MayurPatil2711/ES-408-Mechatronics-/Project Proposal/Firefighting tank rough sketch .png

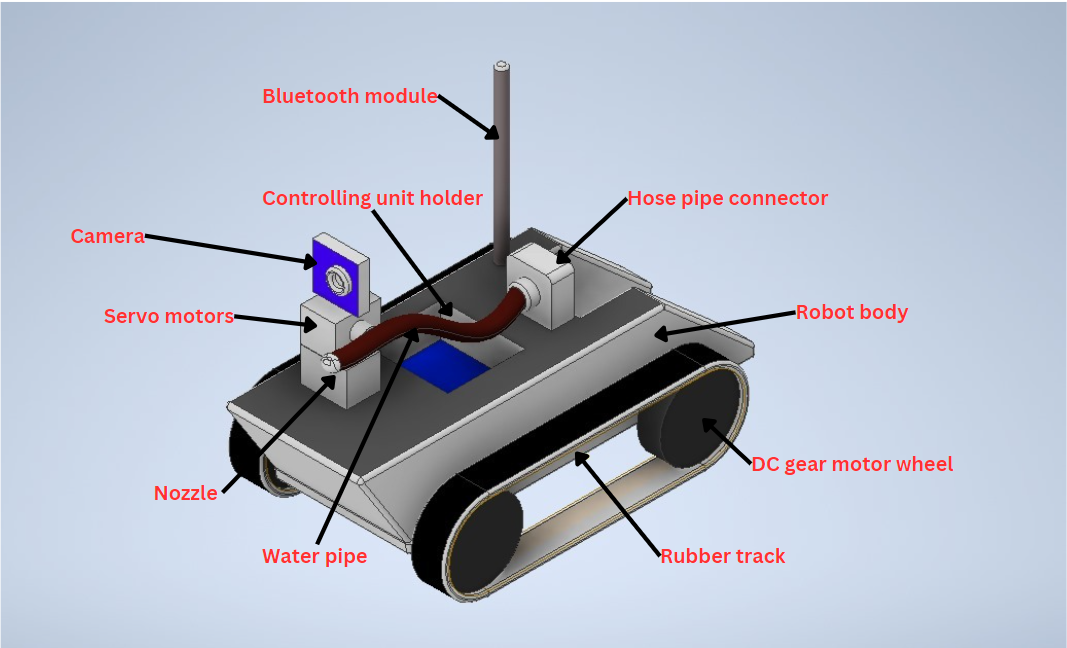
Project Proposal/Firefighting tank rough sketch .png
