MayurPatil2711/ES-408-Mechatronics-/Final Model/IMG-20241117-WA0011.jpg

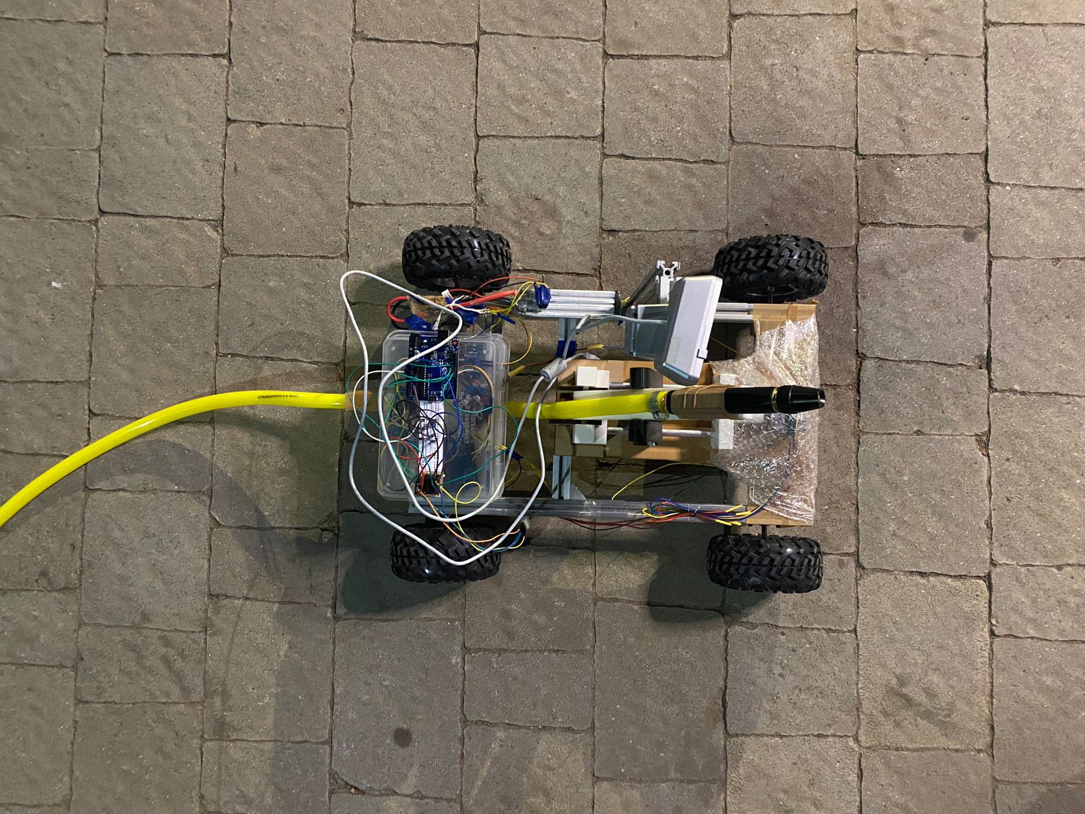
Final Model/IMG-20241117-WA0011.jpg
