MayurPatil2711/ES-408-Mechatronics-/README.md

# ES-408-Mechatronics-

This reposatory contains all the files related to project, and the details of the all the discussion held within team and discussion of team members with Prof. Madhu Vadali.
