MayurPatil2711/ES-408-Mechatronics-/Project Proposal/README.md

# Project Proposal:

This folder contains all the files that are created during the time of project proposal submission.

Here is the tentative design of **Fire-fighting Robot:**

WhatsApp Image 2024-08-21 at 20 00 33_417d19be
