MayurPatil2711/ES-408-Mechatronics-/Discussions/4 Aug 2024.md

# Short Notes on dicussion with Prof. Madhu Vadali on 4/9/2024:

He highlighted the importance of understanding the core mechanisms involved in the project, such as using sensors (like ultrasonic imitators and receivers) and considering the right connections for detection. The discussion explored the idea of integrating a thermal camera to detect heat signatures and identify fire locations.

He also stressed that while the practical demonstration of the robot may not involve real fire, it’s essential to have a theoretical understanding of how the robot would function in real-world conditions. This includes potentially replacing vision-based sensors with thermal detection to locate fire sources accurately.

Additionally, there was a focus on exploring intellectual property (IP) related to the design and intelligence of fire detection and control systems. The instructor encouraged researching patents and considering novel approaches, such as moving only the hose (similar to how a tank’s turret operates) instead of the entire vehicle to aim at fire sources. He also suggested combining multiple technologies, such as smoke detection alongside visual input, to enhance the robot's capabilities.

The discussion wrapped up with the idea of working on the detection system by the end of the lecture, integrating mechatronic concepts, and thinking through the overall control strategy. This step would help in refining the robot’s design and preparing for future improvements in fire-targeting mechanisms.
