MayurPatil2711/ES-408-Mechatronics-/Final Model/ES 408 Fire Fighting Robot (1).pdf

# Fire-Fighting Robot

# Group-9

Nitya Shah | 21110191
Arjun Paan | 23110041

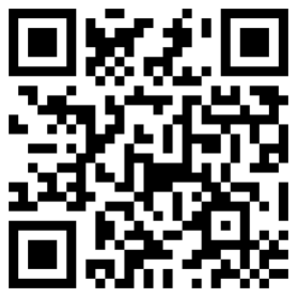
[picture p3: figure]

Github Page

## Problem Statement

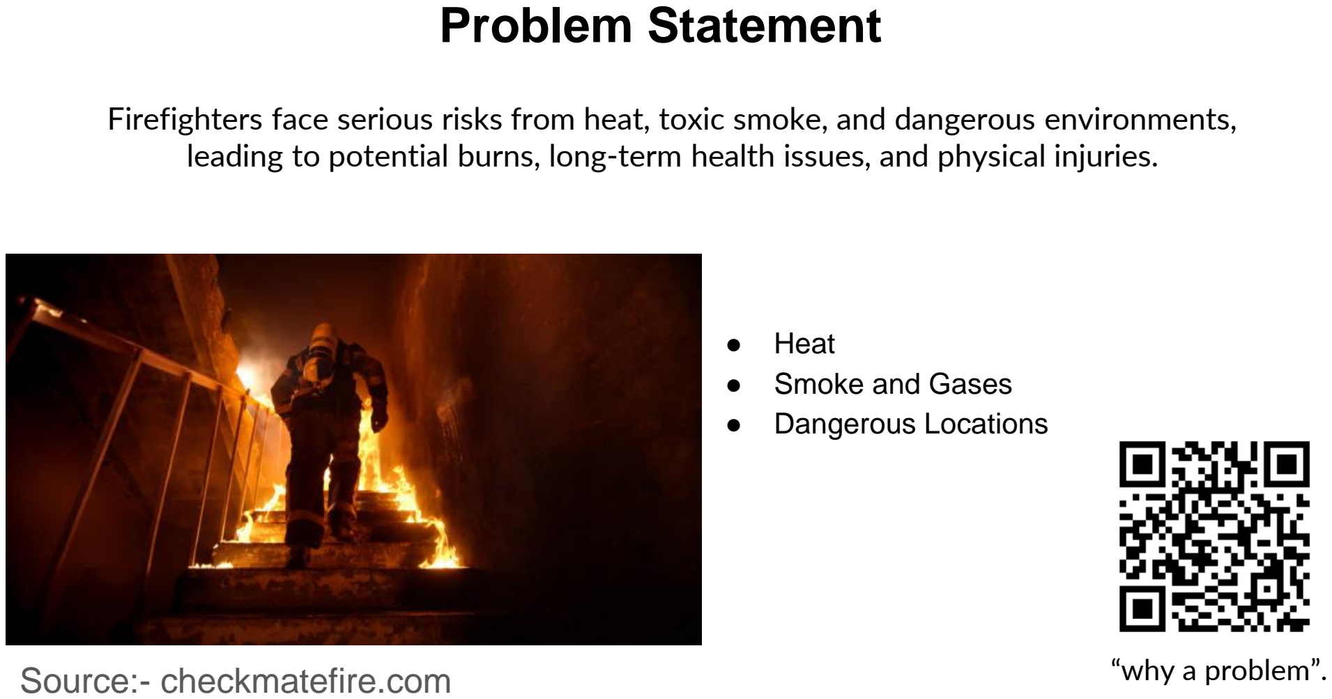
[picture p4: page 2]

- Heat
- Smoke and Gases
- Dangerous Locations

“why a problem”.

Firefighters face serious risks from heat, toxic smoke, and dangerous environments, leading to potential burns, long-term health issues, and physical injuries.

Source:- checkmatefire.com

## Proposed Solution

Developing the fire fighting robots to enhance the safety of the firefighters.

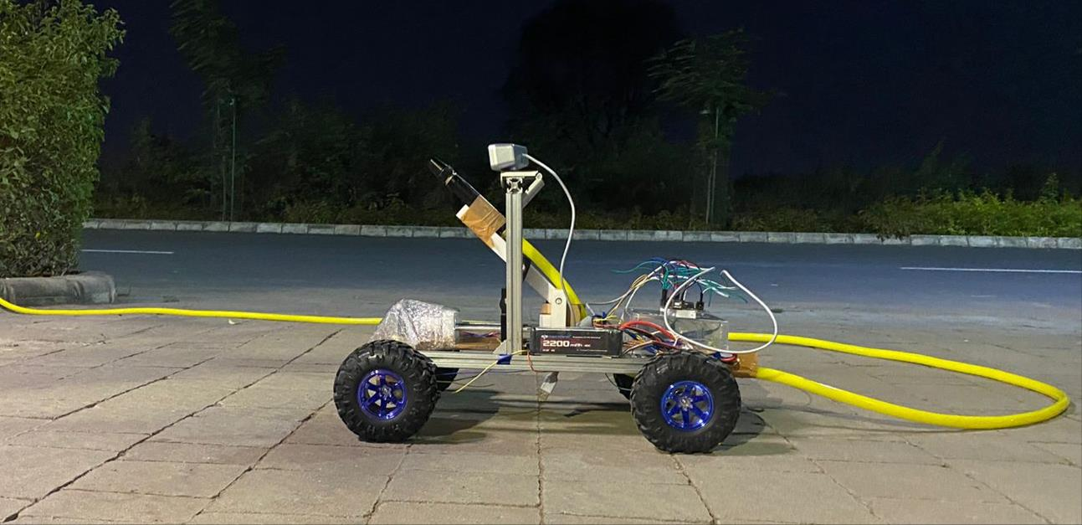
[picture p5: figure]

## Proposed Design

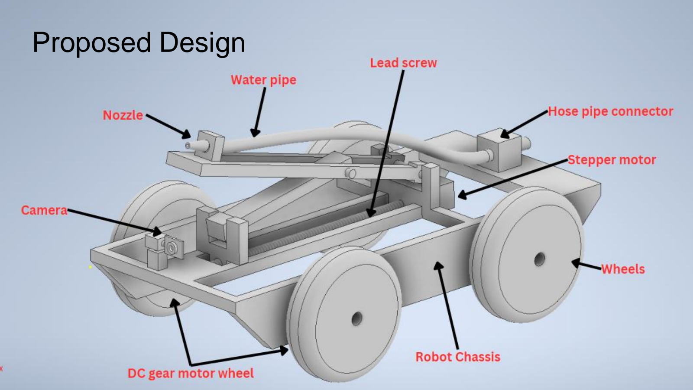
[picture p6: page 4]
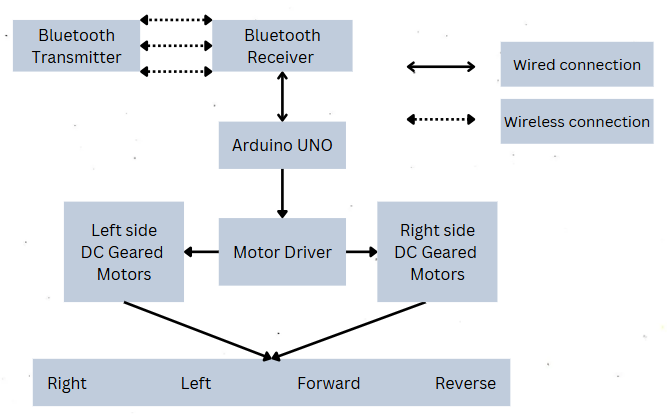
[picture p7: page 5]

Mechatronic Architecture For Motion Control

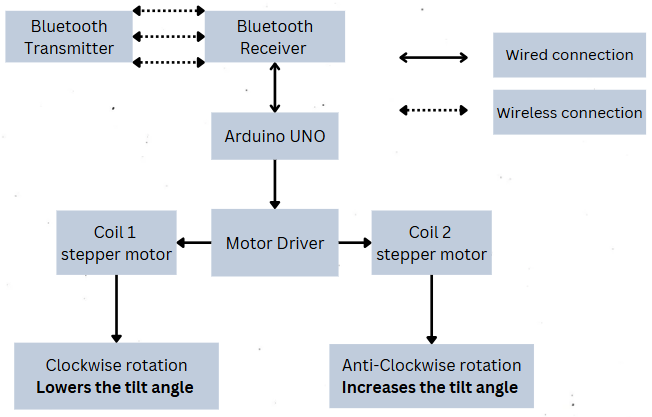
[picture p8: page 6]

Mechatronic Architecture for Tilt Mechanism Control

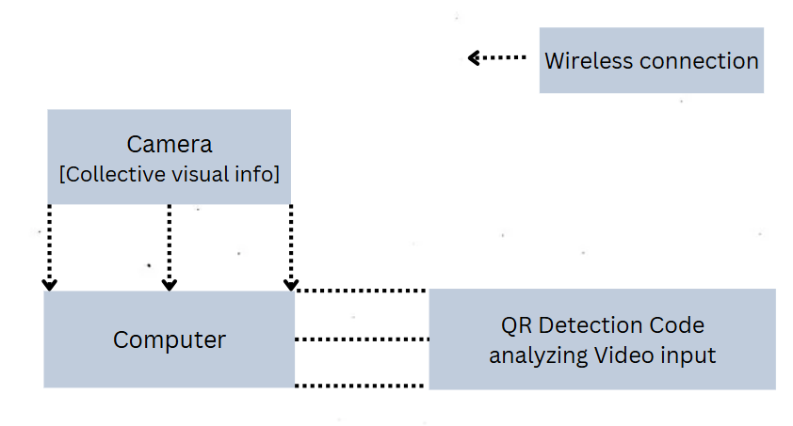
[picture p9: page 7]

Mechatronic Architecture for QR Detection

## Robot’s Capacity

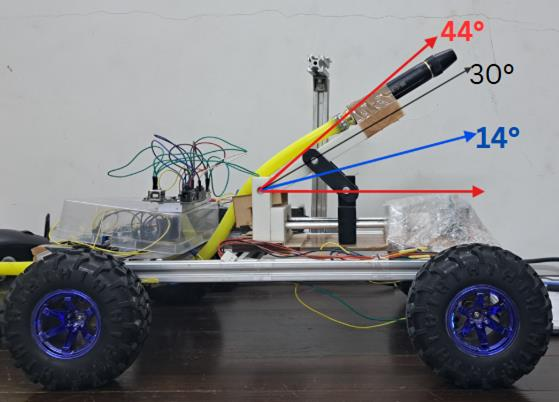
[picture p10: figure]

Avg. Velocity of Robot = 0.4 m/s

Vel. of water from nozzle = 6.4 m/s

@ Water flow rate = 250ml/s

- Range of water jet = 1.9 - 4.5 m
- Max range @ θ = 44° is 4.2 - 4.3m
- Min range @ θ = 14° is 1.9 - 2.2m

## Image of Prototype

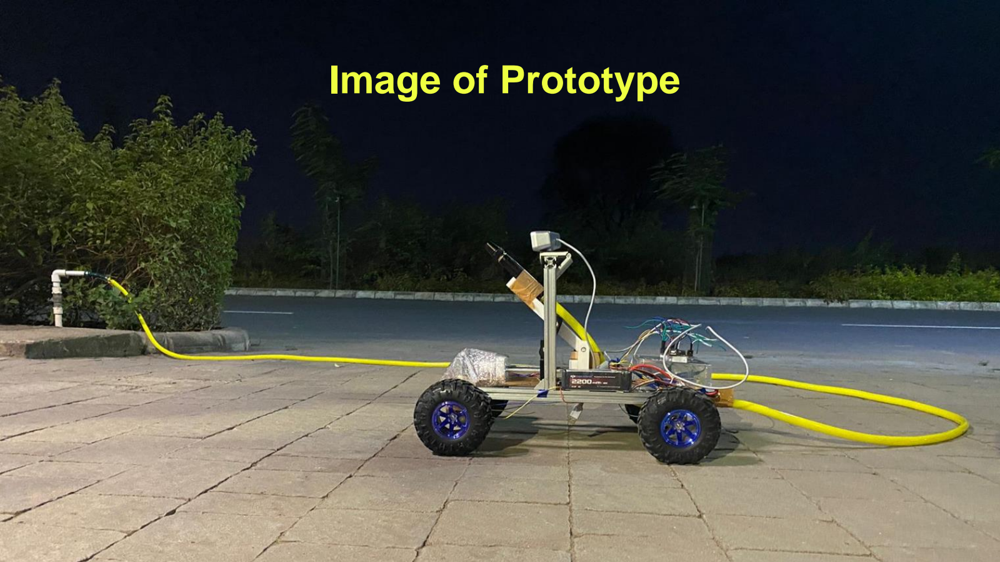
[picture p11: page 9]

## Video Demonstration

1. "Fire {QR} Detection & Water Targeting"
1. "Robot Navigating Compact Spaces for Fire Inspection"
1. "Extinguishing Large Open Fire"

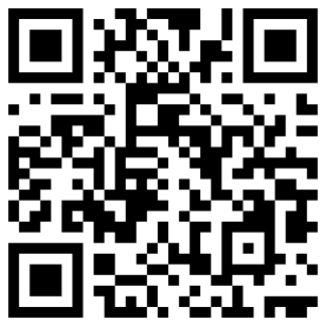
[picture p12: figure]

Video
Demonstration

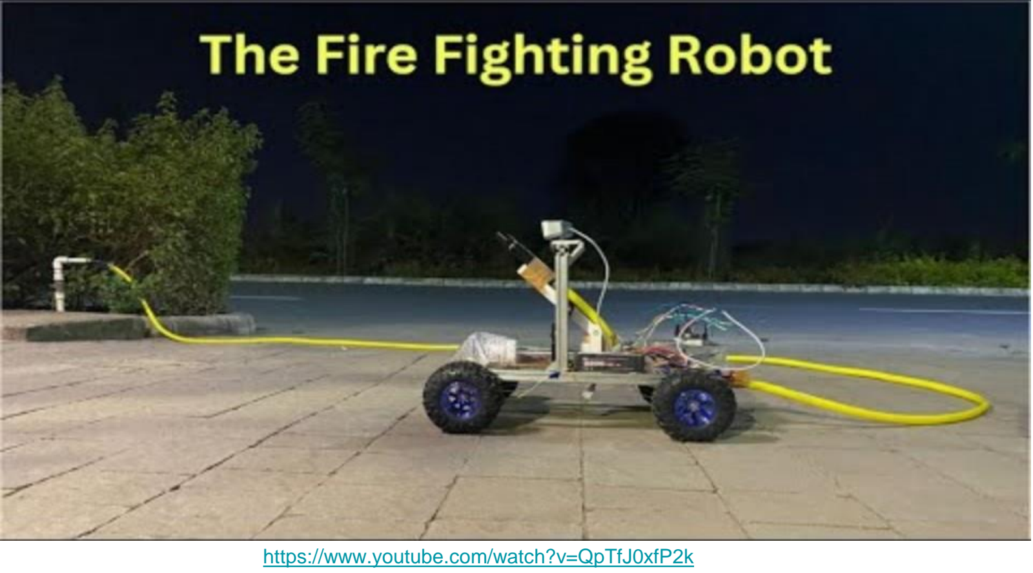
[picture p13: page 11]

https://www.youtube.com/watch?v=QpTfJ0xfP2k

## Conclusion and Future Development

- Aim to make it fully autonomous
- Ensuring rapid deployment
- Eliminating the need for skilled operators,
- Making fire response faster and more efficient.

This robot offers manual control, enabling fire suppression in tight, hazardous spaces where firefighters can't easily reach.

# Thank You

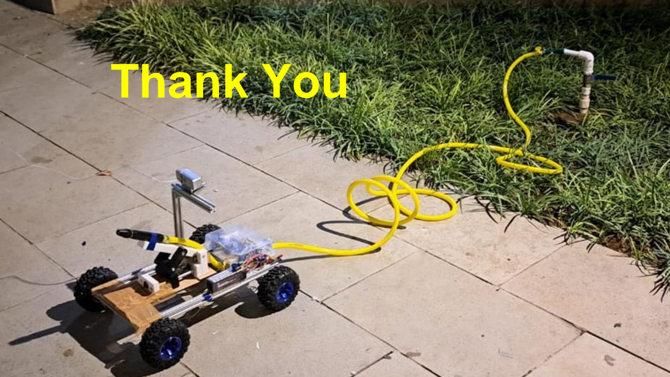
[picture p14: page 13]
