MayurPatil2711/ES-408-Mechatronics-/Discussions/PPT Updates/PPT-1.pdf

# Fire-Fighting Robot

# Group-9

Nitya Shah | 21110191
Mayur Patil | 21110126

## Problem Statement

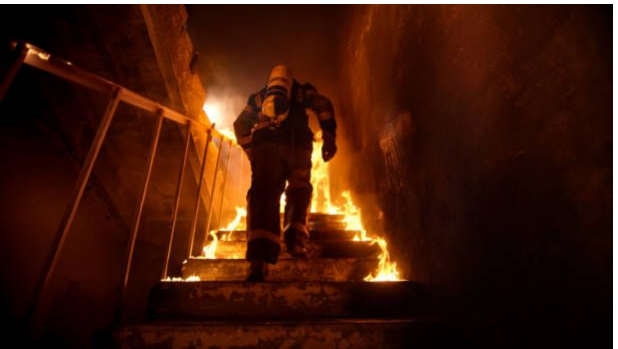
[picture p15: figure]

- Heat
- Smoke and Gases
- Dangerous Locations

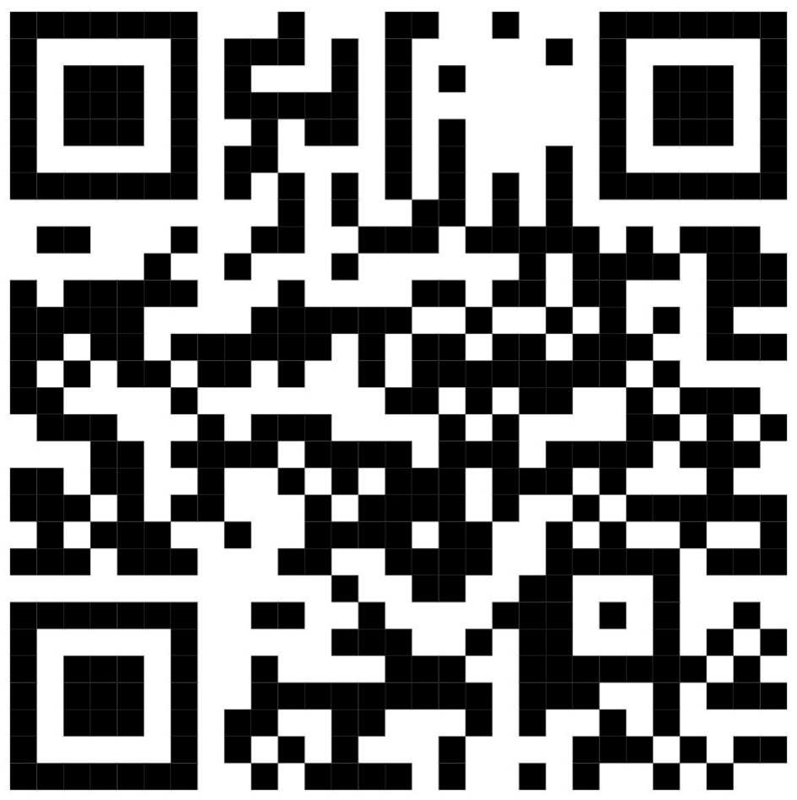
[picture p16: figure]

“why a problem”.

Firefighters face serious risks from heat, toxic smoke, and dangerous environments, leading to potential burns, long-term health issues, and physical injuries.

## Proposed Solution

Developing the fire fighting robots to enhance the safety of the firefighters.

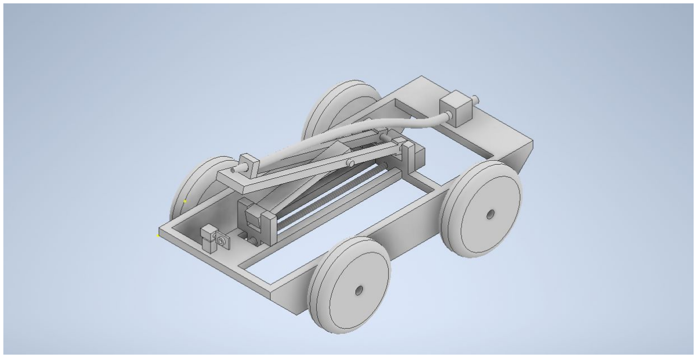
[picture p17: figure]
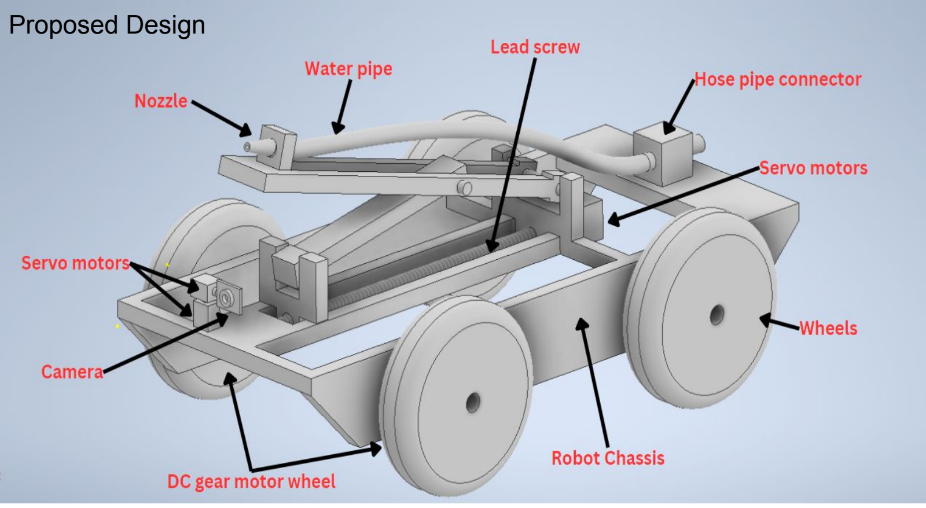
[picture p18: page 4]

### Proposed Design
