MayurPatil2711/ES-408-Mechatronics-/Discussions/PPT Updates/PPT-2.pdf

# Fire-Fighting Robot

# Group-9

Nitya Shah | 21110191
Mayur Patil | 21110126

## Problem Statement


- Heat
- Smoke and Gases
- Dangerous Locations


“why a problem”.

Firefighters face serious risks from heat, toxic smoke, and dangerous environments, leading to potential burns, long-term health issues, and physical injuries.

## Proposed Solution

Developing the fire fighting robots to enhance the safety of the firefighters.


### Proposed Design

### Mechatronic Architecture for Vision

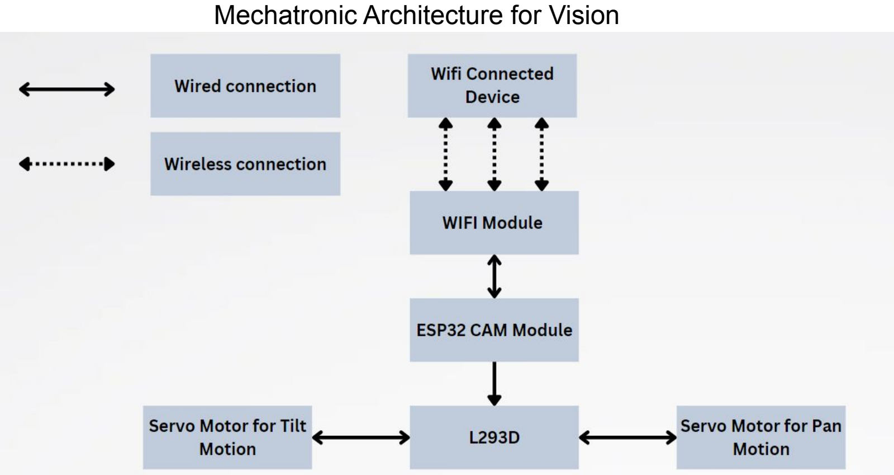
[picture p19: page 5]
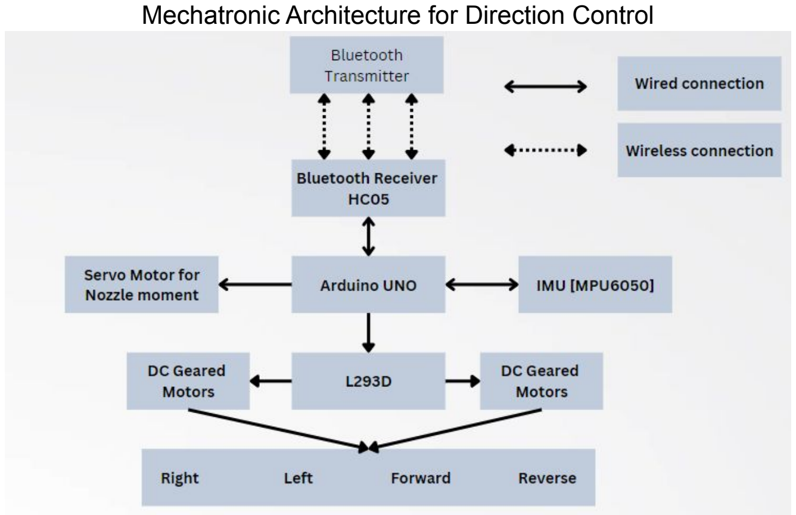
[picture p20: page 6]

Mechatronic Architecture for Direction Control
