MayurPatil2711/ES-408-Mechatronics-/Detailed sketches with Bill of Materials/Mechatronics Architecture.pdf

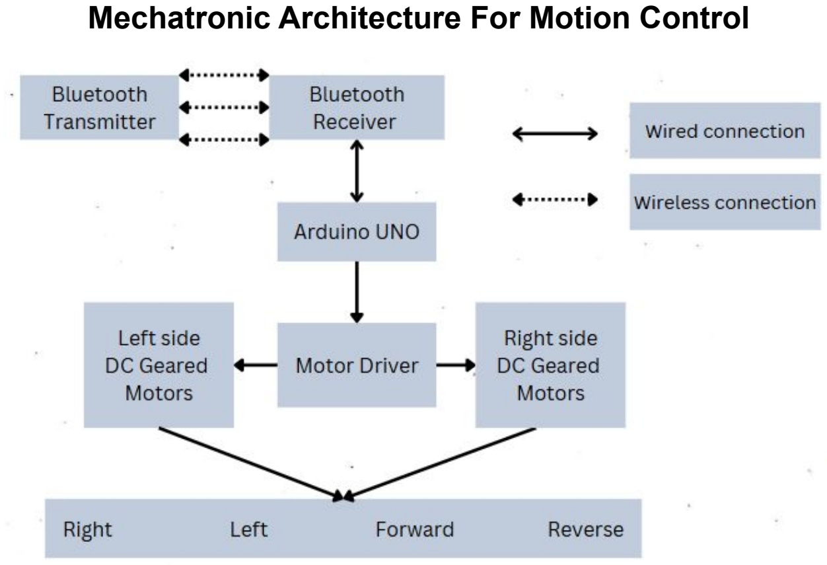
[picture p31: page 1]

Mechatronic Architecture For Motion Control

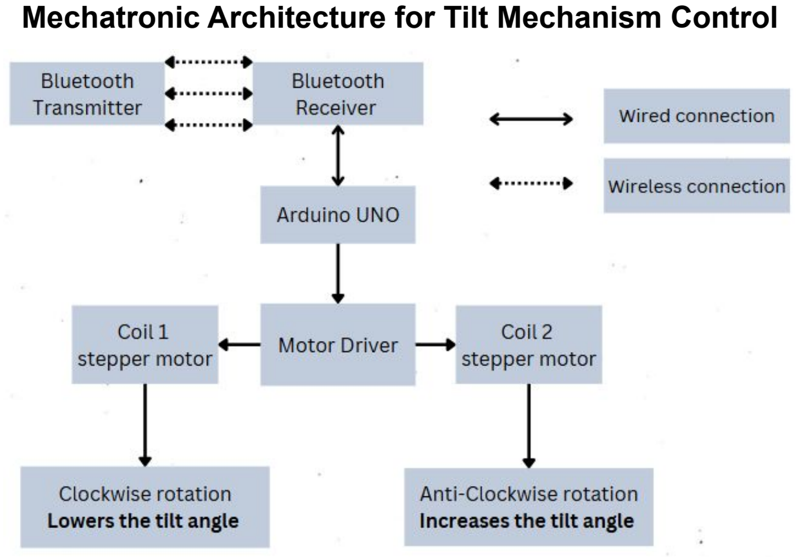
[picture p32: page 2]

Mechatronic Architecture for Tilt Mechanism Control
