MayurPatil2711/ES-408-Mechatronics-/Calculations/Calculations Summary .png

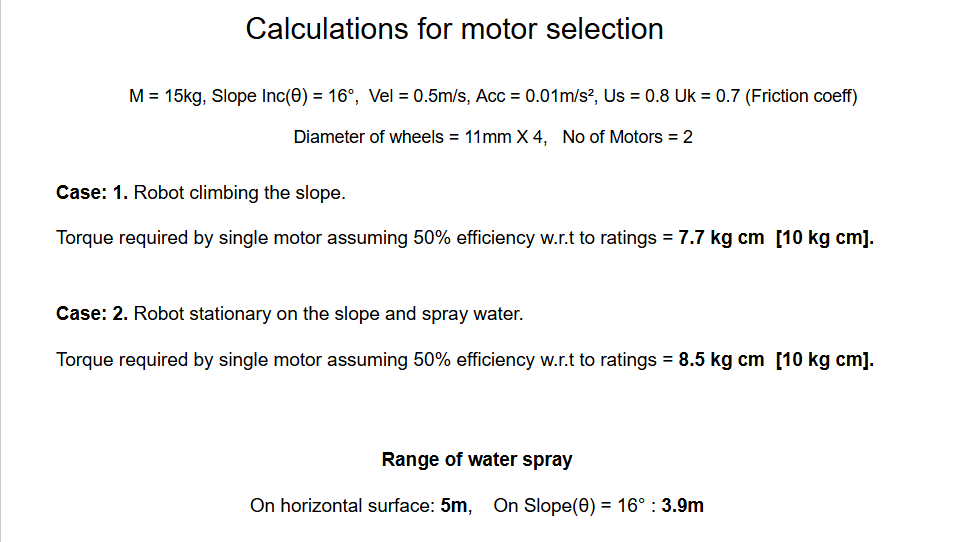
Calculations/Calculations Summary .png
