MayurPatil2711/ES-408-Mechatronics-/Calculations/Motor power requirement calculations.jpg

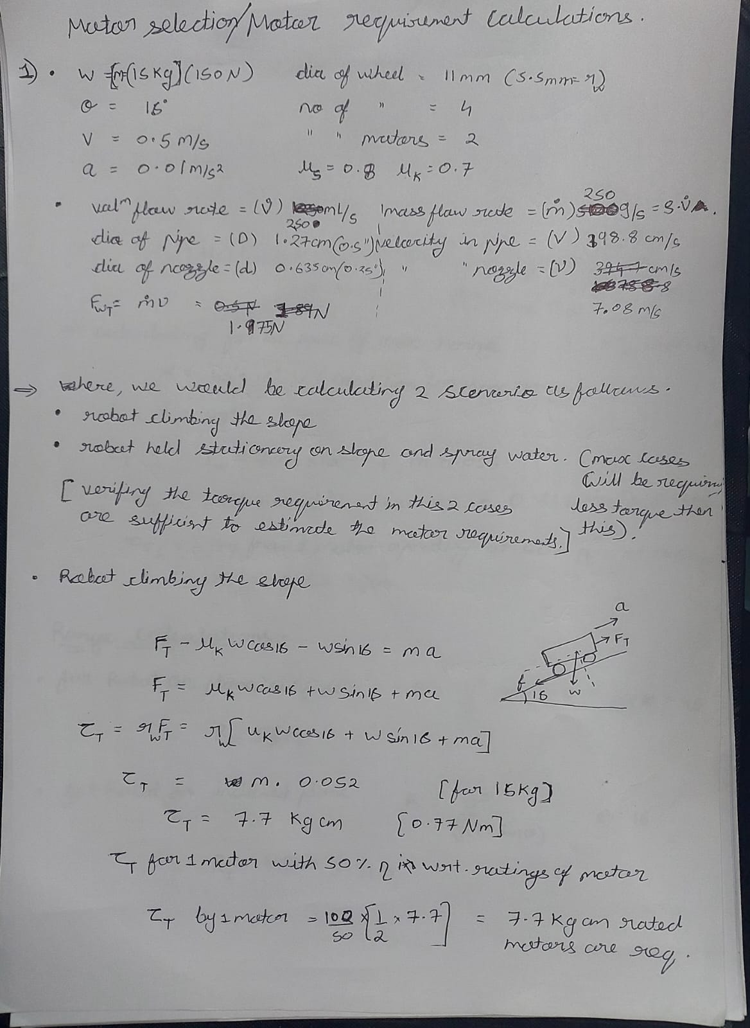
Calculations/Motor power requirement calculations.jpg
