MayurPatil2711/ES-408-Mechatronics-/Calculations/Range calculations.jpg

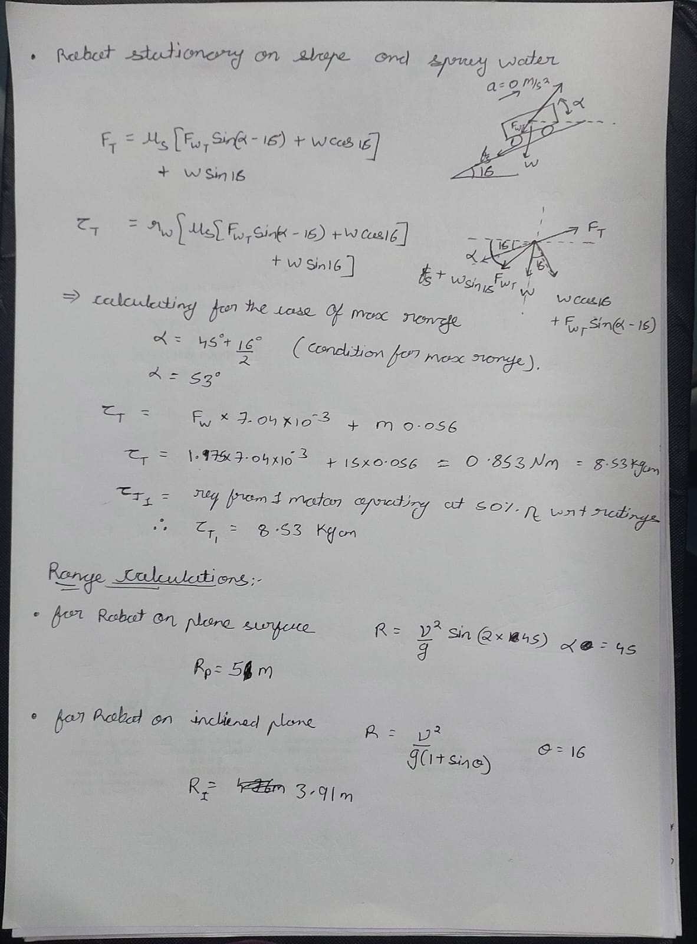
Calculations/Range calculations.jpg
