MayurPatil2711/ES-408-Mechatronics-/Discussions/Rough Calculations/Rough Calculations.jpg

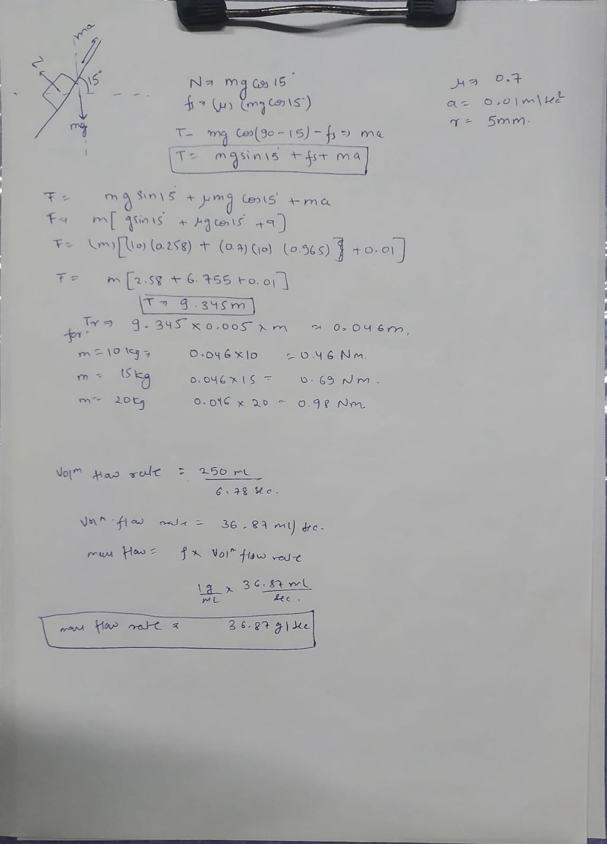
Discussions/Rough Calculations/Rough Calculations.jpg
