MayurPatil2711/ES-408-Mechatronics-/Final Model/IMG-20241117-WA0005.jpg

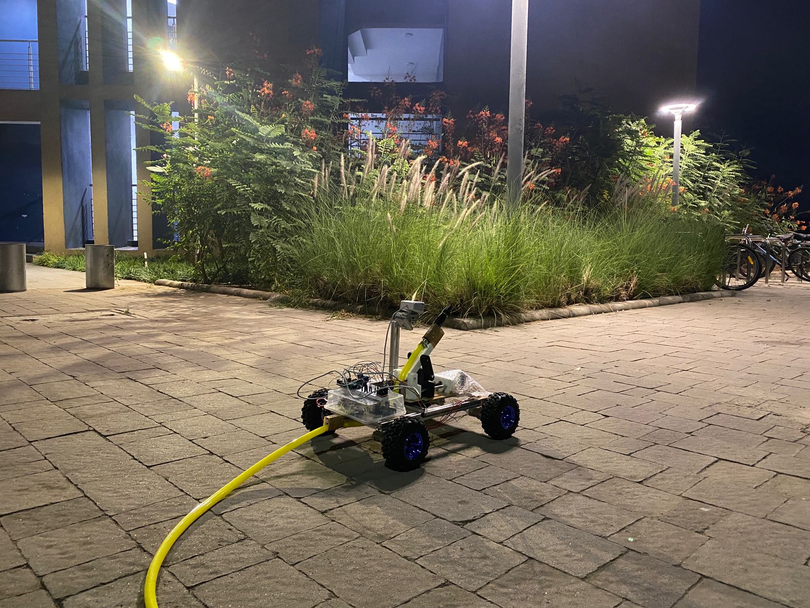
Final Model/IMG-20241117-WA0005.jpg
