MayurPatil2711/ES-408-Mechatronics-/(list of files, cad)

Other CAD files:
Project Proposal/Rough Sketch.ipt
