MayurPatil2711/ES-408-Mechatronics-/Project Proposal/Why a problem_.pdf

In recent weeks, the perilous nature of firefighting has been starkly highlighted by a series of tragic incidents. In Los Angeles, two firefighters are in critical condition, with several others injured following a devastating explosion. Meanwhile, in Karol Bagh, six firefighters sustained injuries from an LPG cylinder burst during intense firefighting operations. The dangers faced by these brave men and women are underscored by the grim statistic that six firefighters have lost their lives during rescue operations since 2016. Adding to the toll, a forest fire in Almora’s Binsar Forest has claimed the lives of four firefighters and left four more injured while they bravely battled the blaze. These incidents serve as a sobering reminder of the risks inherent in firefighting and the valour of those who confront these dangers head-on.

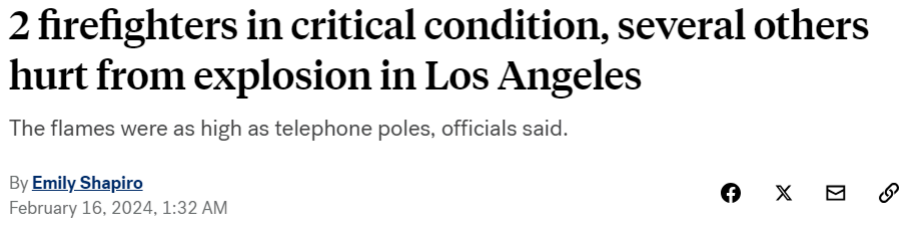
[picture p45: figure]

Source (https://abcnews.go.com/US/2-firefighters-critical-condition-hurt-explosion-los-angeles/story?id=107262302)

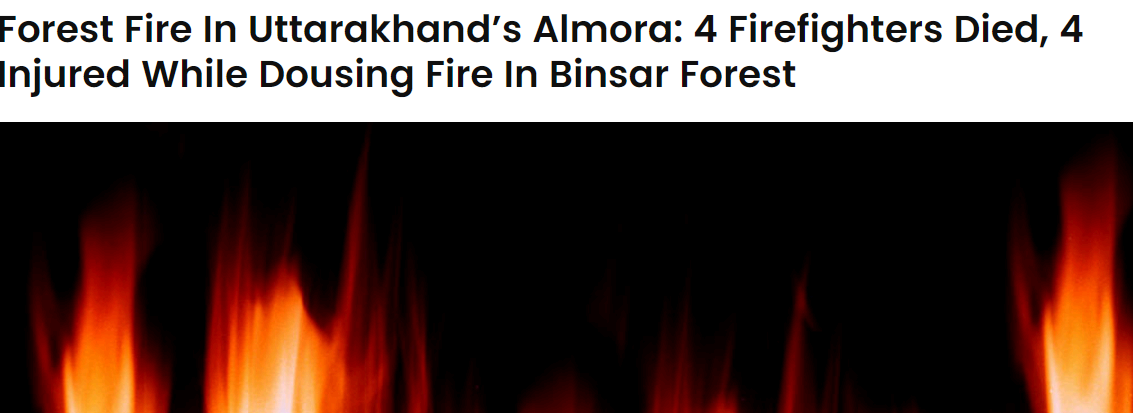
[picture p46: figure]

Source (https://www.aninews.in/news/national/general-news/forest-fire-in-uttarakhands-almora-4-firefighters-died-4-injured-while-dousing-fire-in-binsar20240613220421/)

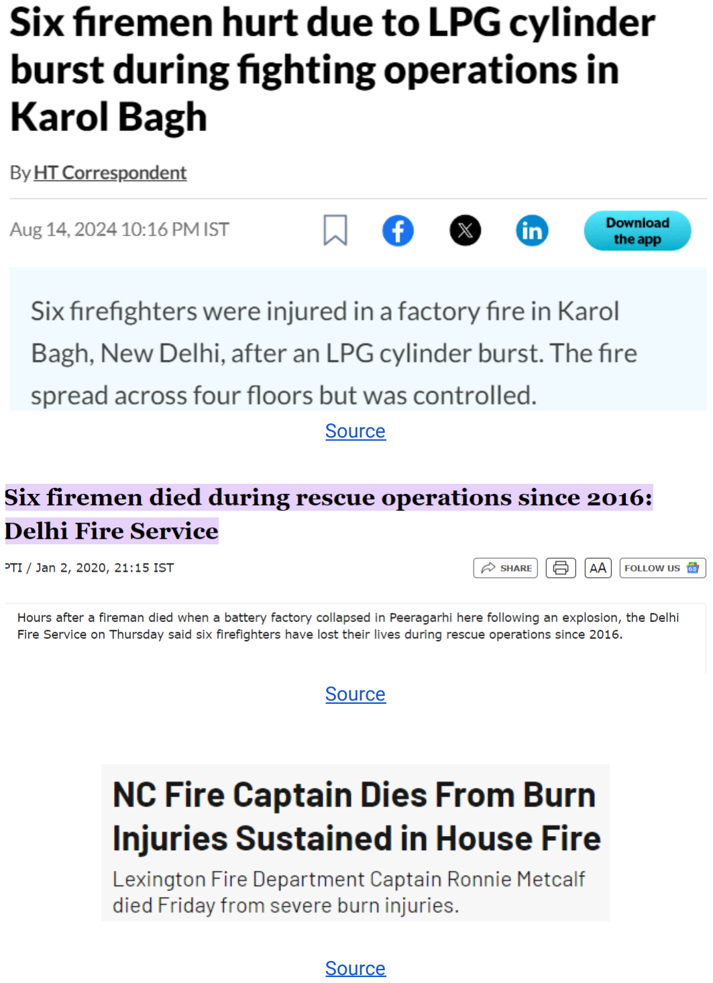
[picture p47: page 2]

Source (https://www.hindustantimes.com/cities/delhi-news/six-firemen-hurt-due-to-lpg-cylinder-burst-during-fighting-operations-in-karol-bagh-101723653991274.html)

Source (https://timesofindia.indiatimes.com/city/delhi/six-firemen-died-during-rescue-operations-since-2016-delhi-fire-service/articleshow/73074626.cms)

Source (https://www.fireengineering.com/health-safety/firefighter-fatalities/#gref)

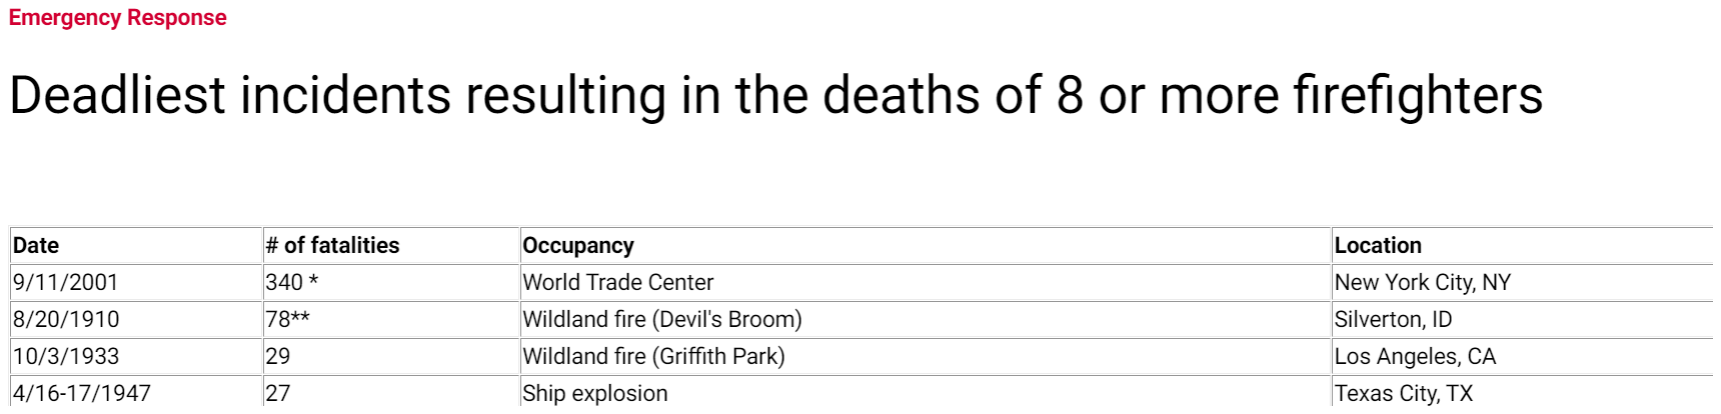
[picture p48: figure]

An 8 percent rise from the 60,750 firefighter injuries recorded in 2021 to a projected 65,650 firefighter injuries in 2022 happened in the course of duty.

Compared to other jobs, firefighters were more likely to have injuries while working on fire grounds. An estimated 21,325 injuries—or 33% of all firefighter injuries reported—occurred on the fire ground in 2022.

https://www.nfpa.org/education-and-research/research/nfpa-research/fire-statistical-reports/firefighter-injuries-in-the-united-states (https://www.nfpa.org/education-and-research/research/nfpa-research/fire-statistical-reports/firefighter-injuries-in-the-united-states)
