MayurPatil2711/ES-408-Mechatronics-/Detailed sketches with Bill of Materials/BOM.pdf

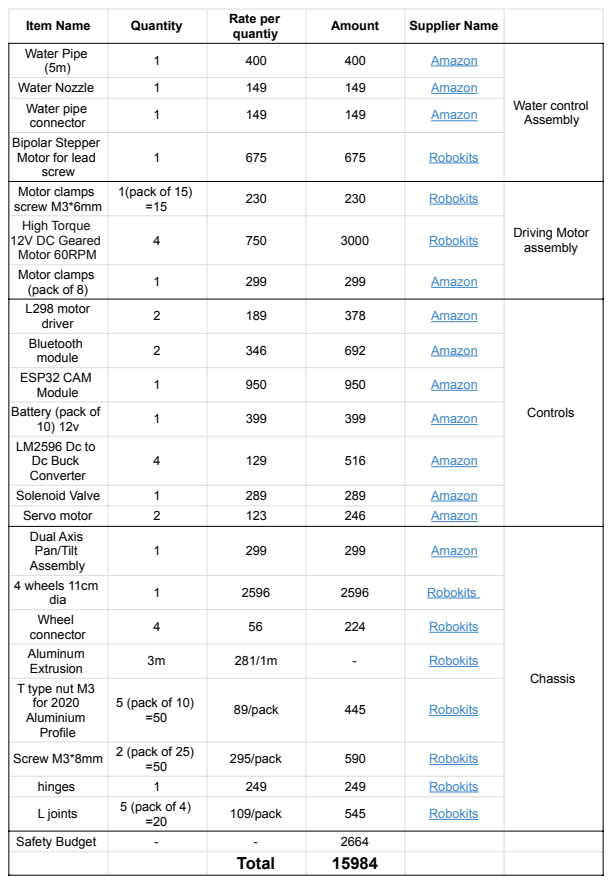
[picture p49: page 1]
Item Name; Quantity; Rate per; quantiy; Amount; Supplier Name; Dual Axis Pan/Tilt Assembly; Amazon; Chassis; 4 wheels 11cm; dia; Robokits; Wheel; connector; Aluminum; Extrusion; T type nut M3 for 2020 Aluminium Profile; 5 (pack of 10); 89/pack; Screw M3*8mm; 2 (pack of 25); 295/pack; hinges; L joints; 5 (pack of 4); 109/pack; Safety Budget; Total

Water Pipe (5m) 1 400 400 Amazon Water Nozzle 1 149 149 Amazon Water pipe connector 1 149 149 Amazon Bipolar Stepper Motor for lead 1 675 675 Robokits screw | Water control Assembly

Motor clamps 1(pack of 15) =15 230 230 Robokits screw M3*6mm

High Torque 12V DC Geared 4 750 3000 Motor 60RPM | Driving Motor Robokits assembly

Motor clamps (pack of 8) | 1 299 | 299 Amazon

L298 motor driver Bluetooth module ESP32 CAM Module Battery (pack of 10) 12v LM2596 Dc to Dc Buck Converter Solenoid Valve Servo motor | 2 189 | 378 | Amazon

2 346 692 Amazon 1 950 950 Amazon 1 399 399 Amazon 4 129 516 Amazon 1 289 289 Amazon 2 123 246 Amazon | | | Controls
