MayurPatil2711/ES-408-Mechatronics-/Detailed sketches with Bill of Materials/Sketch_Fire Fighting Tank.pdf

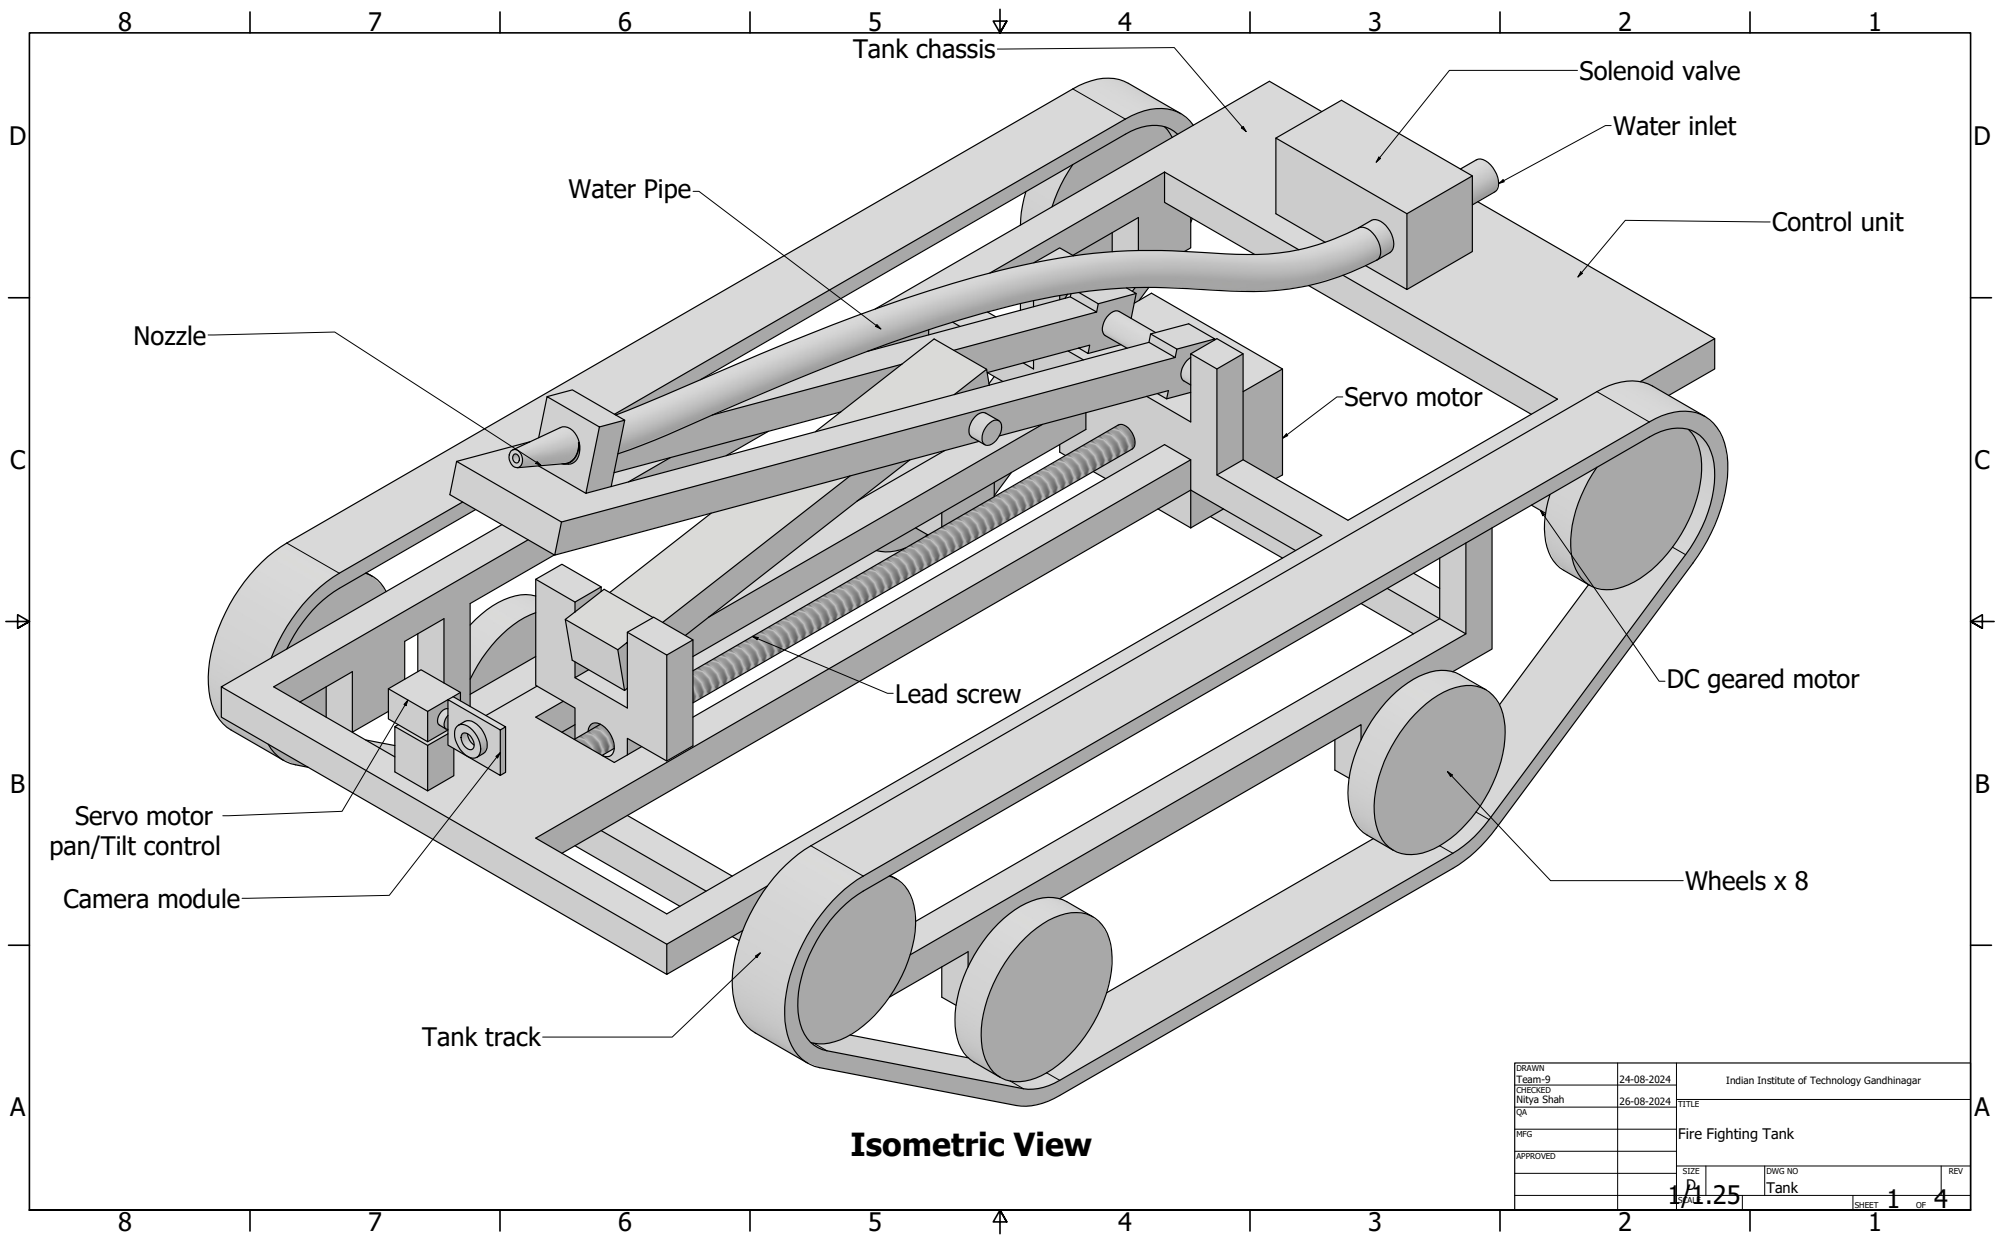
[picture p50: page 1]
SHEET 1 OF 4; DRAWN; CHECKED; MFG; APPROVED; Team-9; Nitya Shah; DWG NO Tank; SIZE D; SCALE; REV; Isometric View; Water Pipe; Solenoid valve; Water inlet; Control unit; Tank chassis; Wheels x 8; Tank track; Camera module; Nozzle; Servo motor; Lead screw

DC geared motor

Servo motor
pan/Tilt control

Indian Institute of Technology Gandhinagar

TITLE
Fire Fighting Tank

n

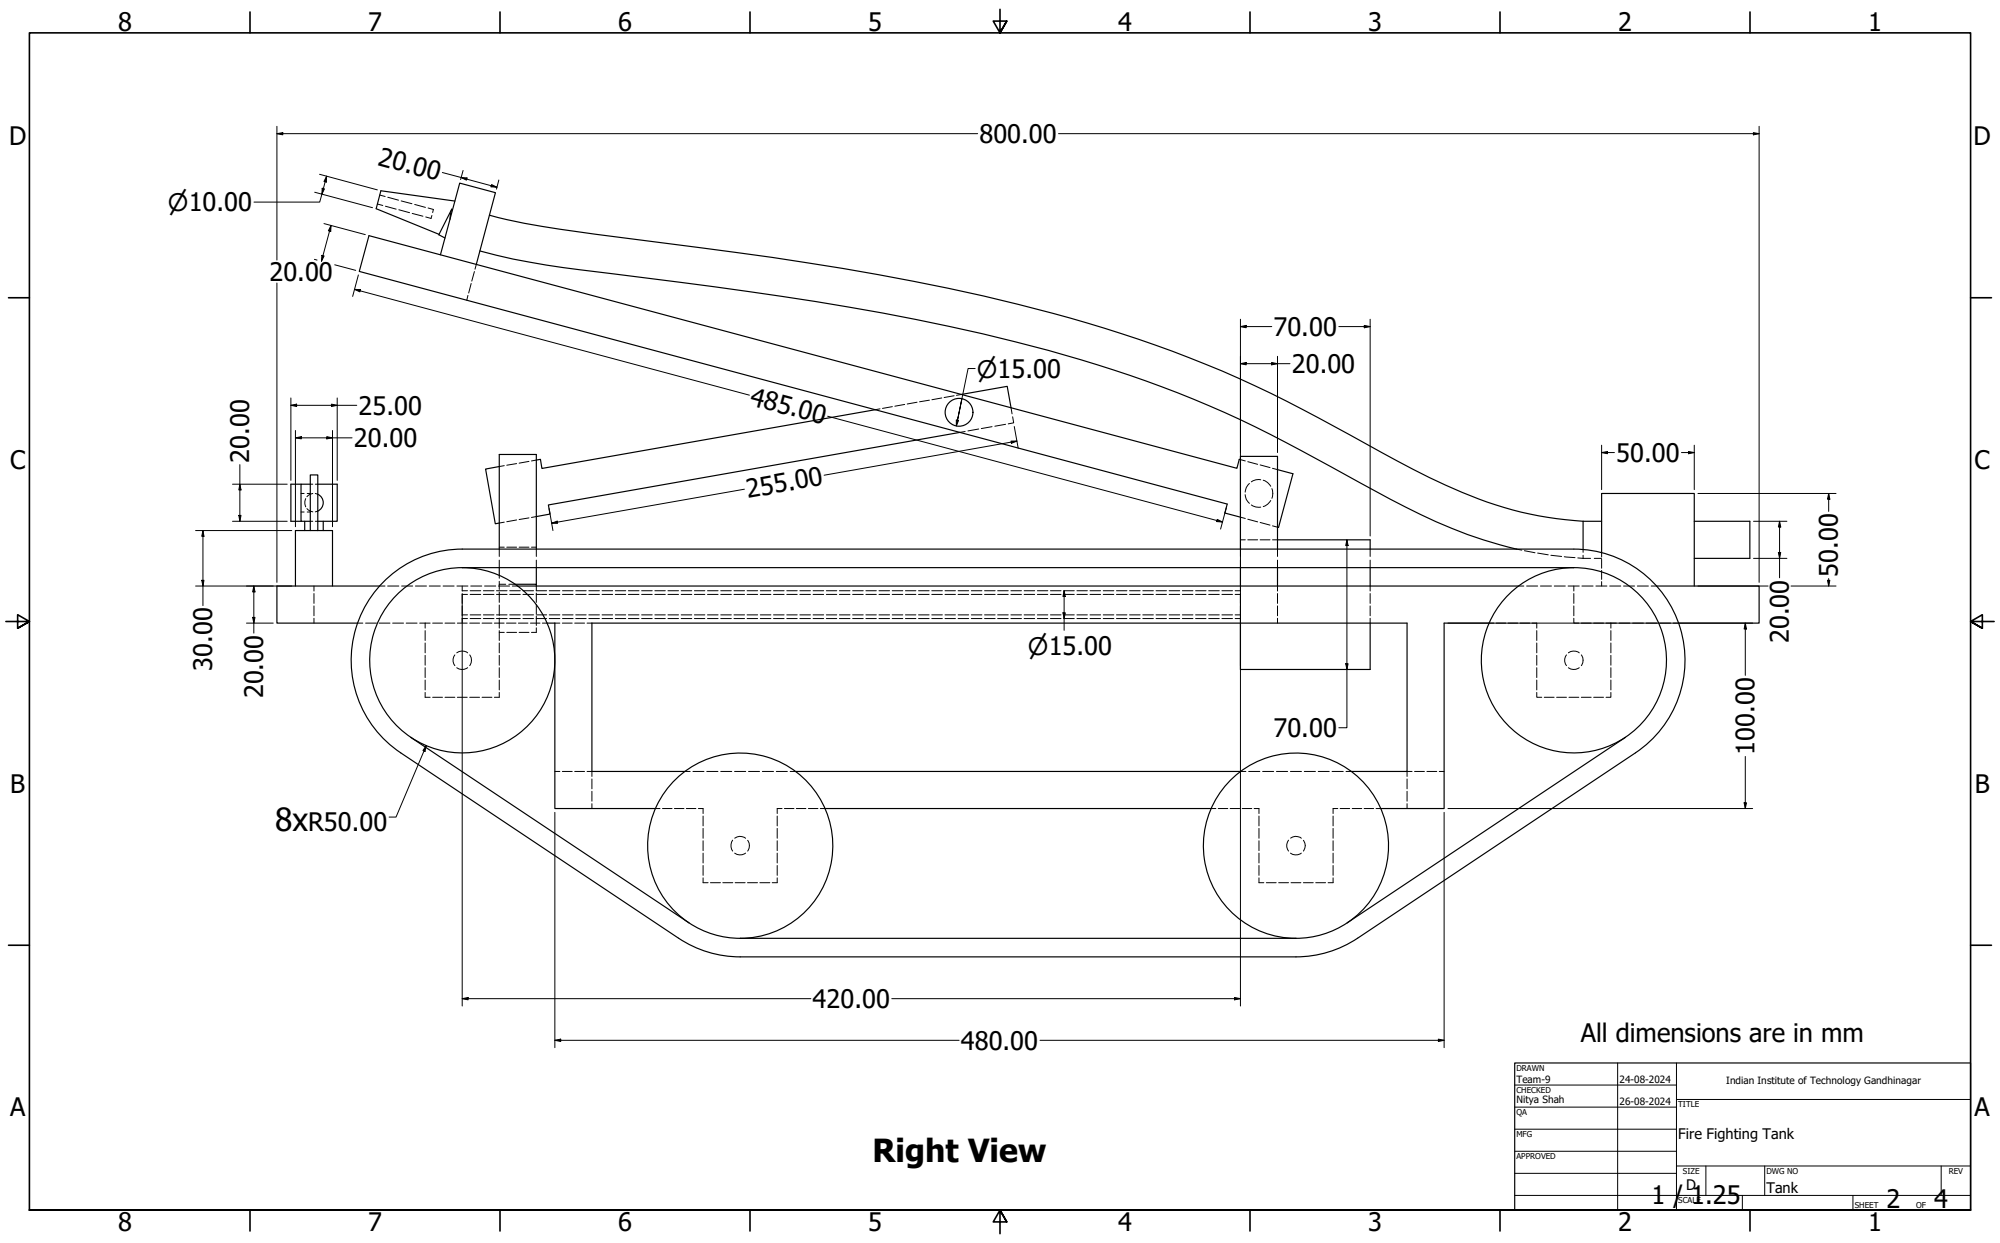
[picture p51: page 2]
olo; All d

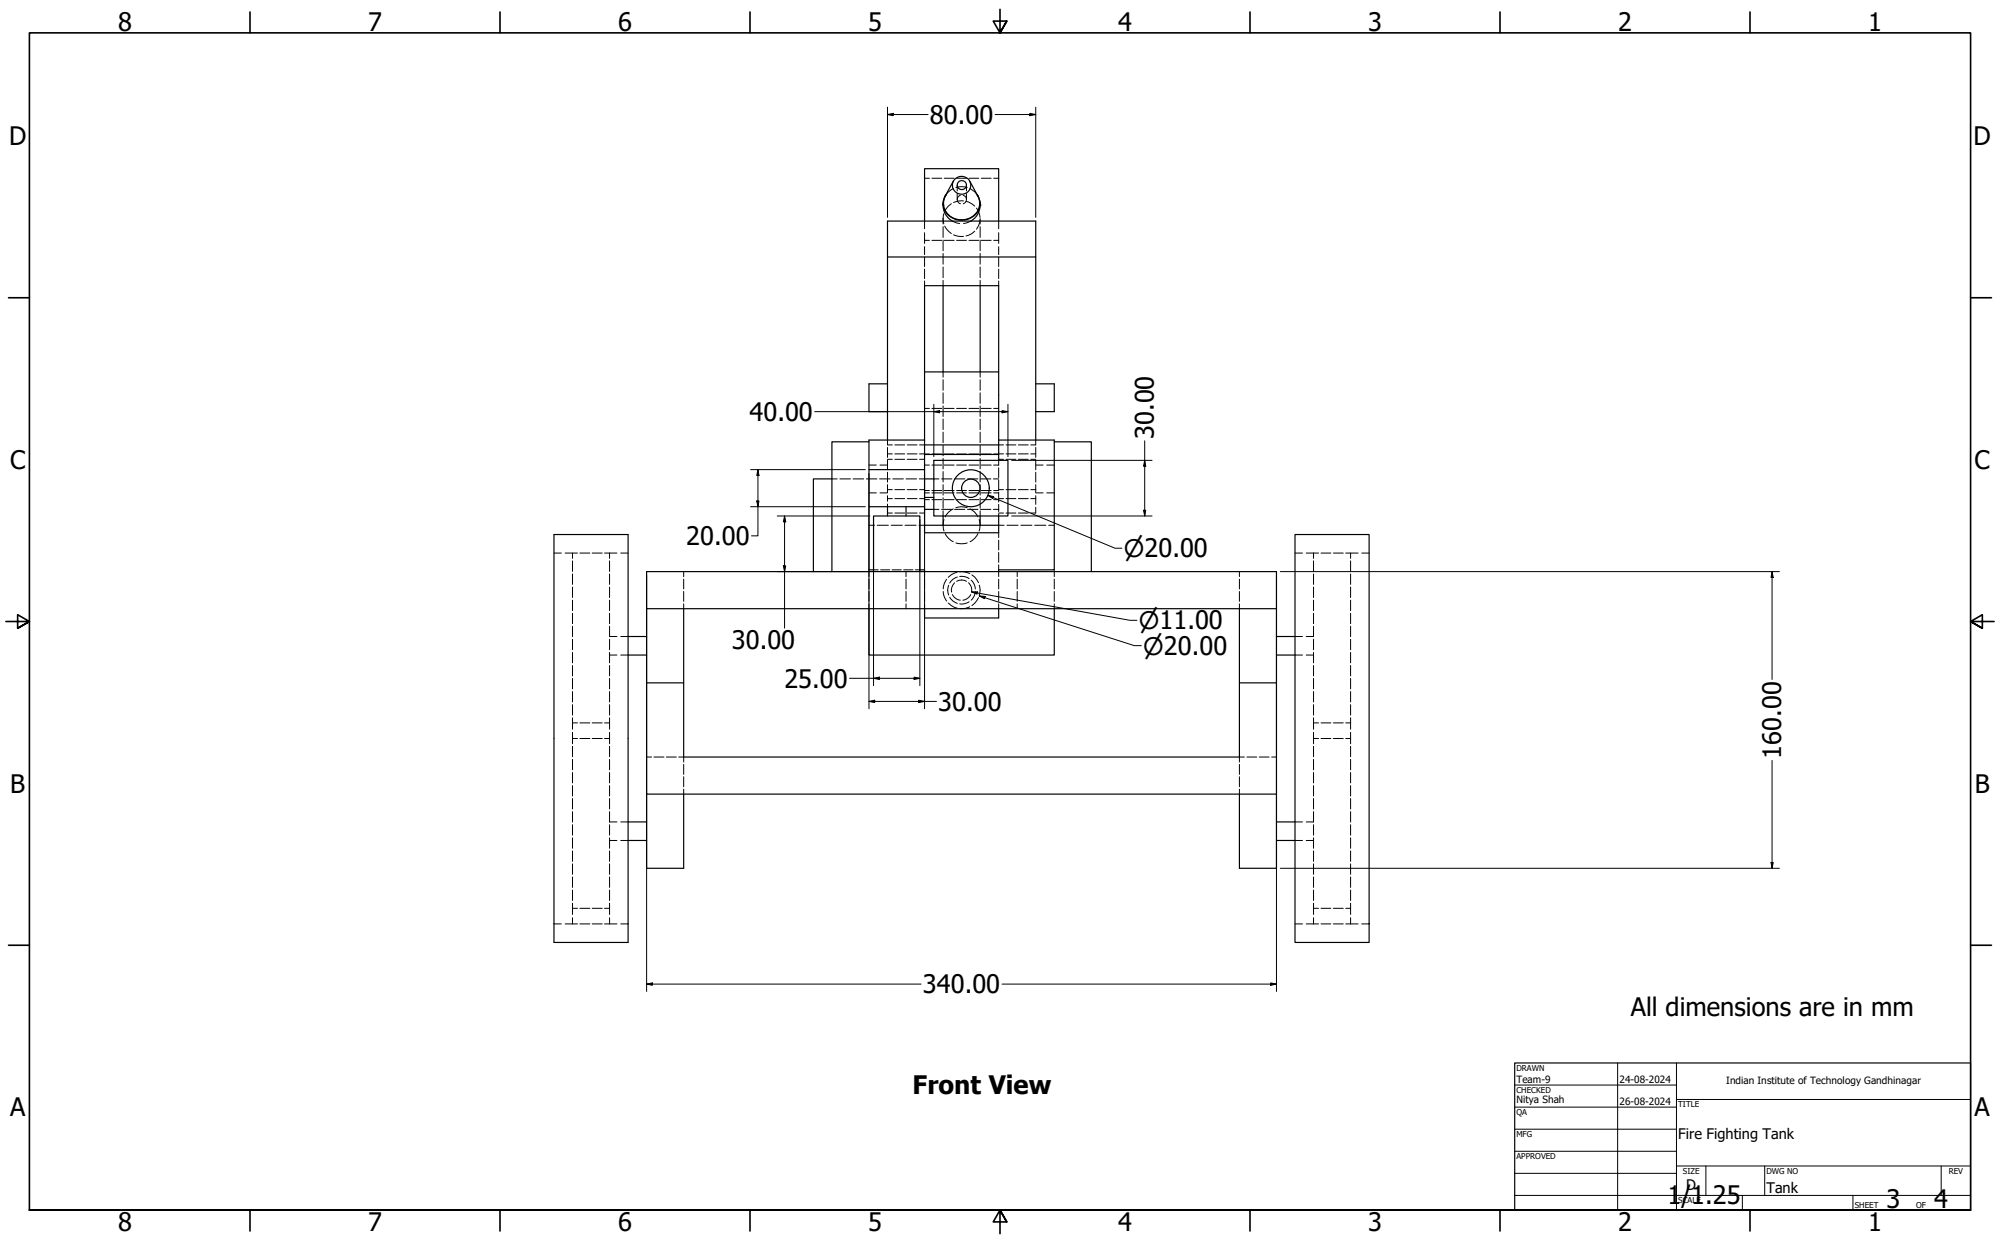
[picture p52: page 3]
SHEET 3 OF 4; DRAWN; CHECKED; MFG; APPROVED; Team-9; Nitya Shah; DWG NO Tank; SIZE; SCALE; REV; Front View

All dimensions are in mm

Indian Institute of Technology Gandhinagar

TITLE
Fire Fighting Tank

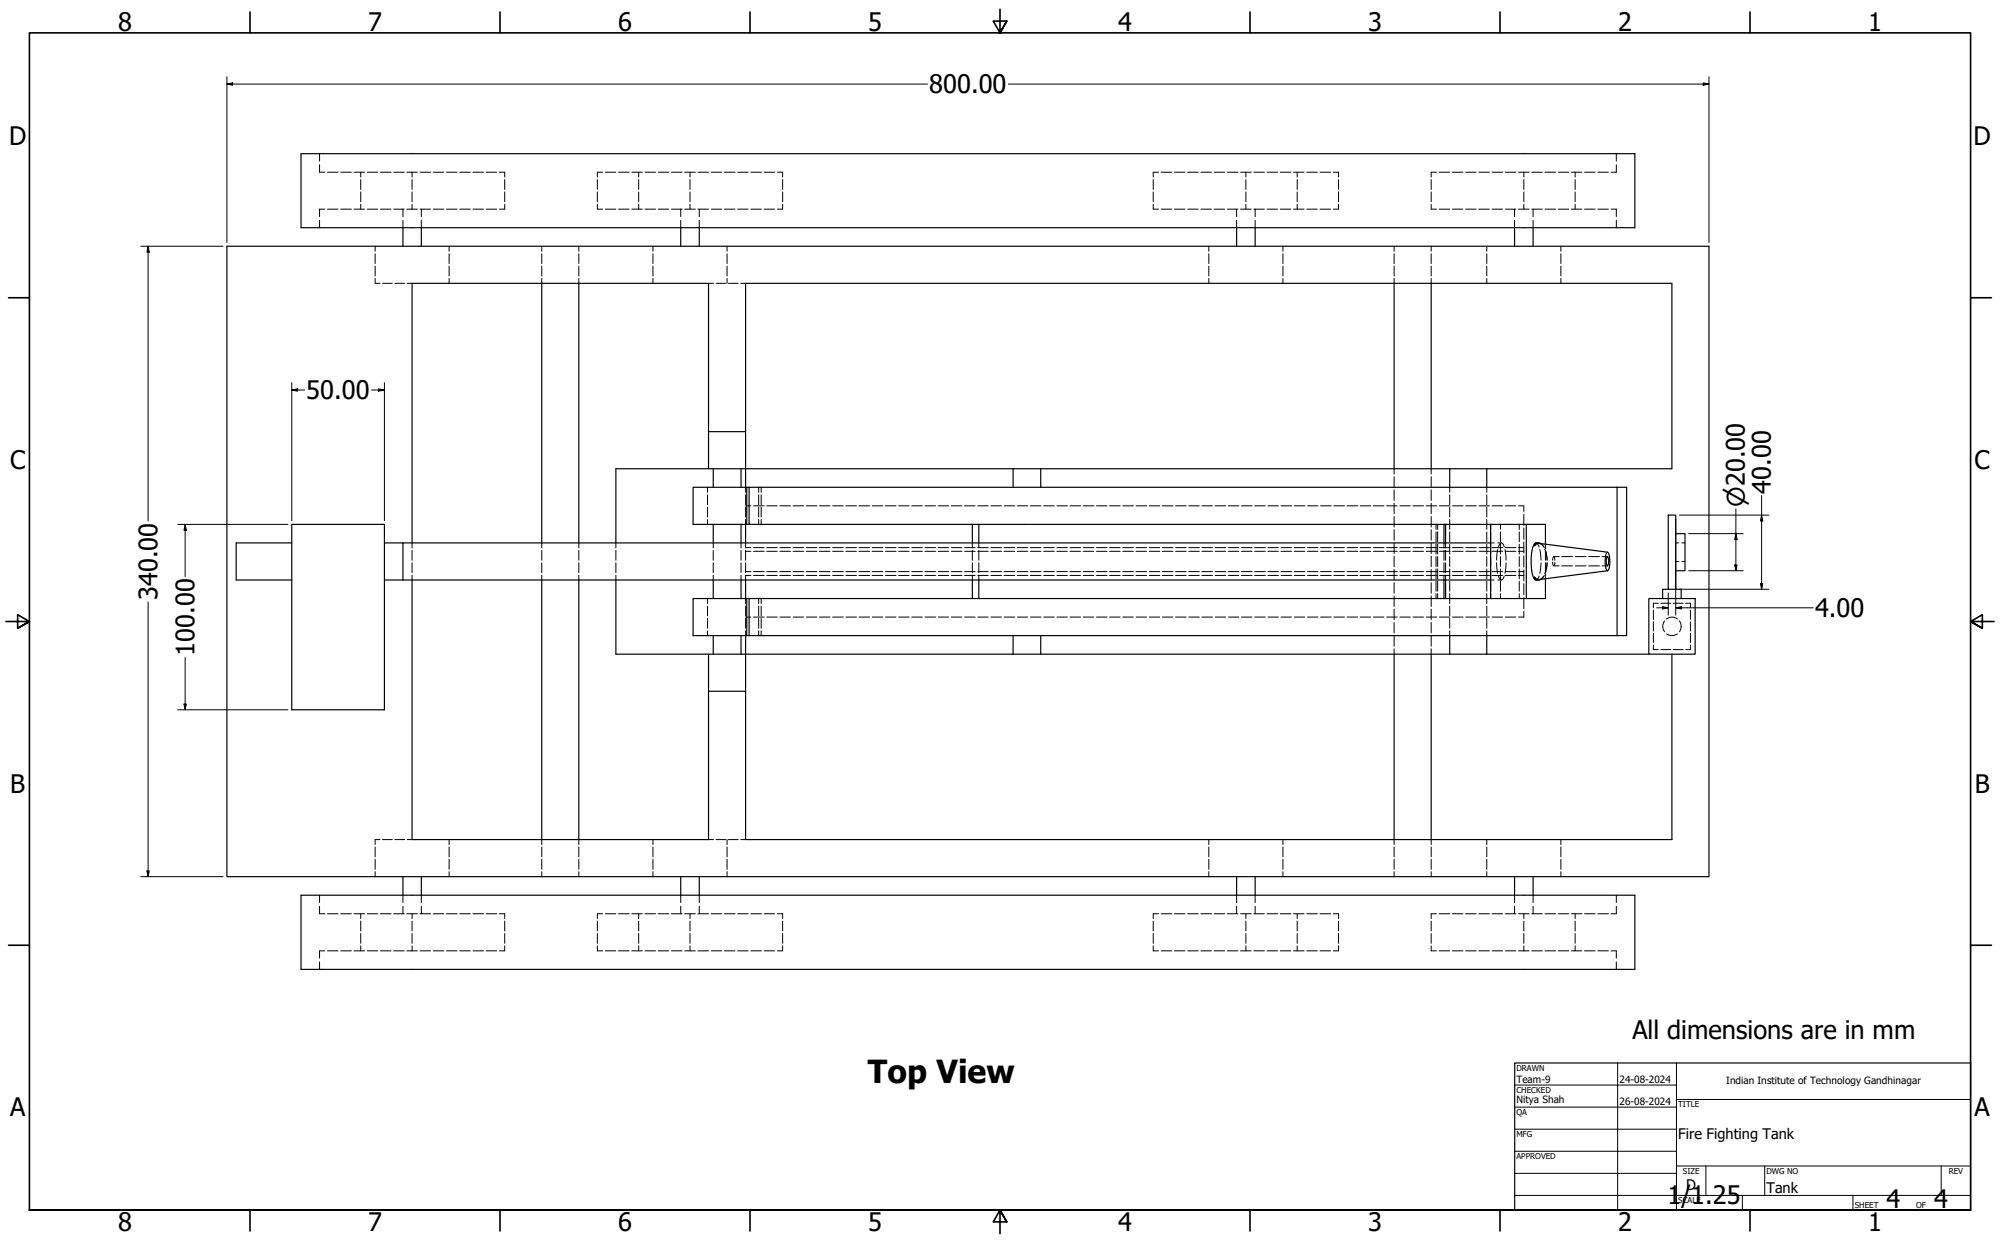
[picture p53: page 4]
olo; 5 n²⁰.00 40.00; All d
