MayurPatil2711/ES-408-Mechatronics-/(commit log)

2024-08-21 Create Problem Statement
    Identified the problem and framed a problem statement.
2024-08-21 Update Problem Statement
    On sir's advice, I re-framed the problem statement, which focuses on the part to reduce the risk of fire-fighting robots.
2024-08-21 Create Problem Statement.md
    Identified the problem and framed problem statement for this.
2024-08-21 Update Problem Statement.md
    On sir's advice, re-framed the problem statement, focusing on reducing the risk of life of fire-fighters.
2024-08-21 Added CAD design
    Created the first rough CAD model of the robot (not to scale).
    [Rough Sketch.ipt]
2024-08-22 Update README.md
    Added image of model, designed on Auto CAD.
2024-09-09 Added this file which contains rough calculations.
    It contains rough calculations of how much torque is needed to move the robot for all elevations till 15 degree from the ground.
2024-09-11 Delete Detailed sketches with Bill of Materials/BOM mechatronics - Sheet1.pdf
    New BOM was made, hence deleting this one.
2024-09-11 Add files via upload
    New Bill of Materials was uploaded.
2024-09-18 Add files via upload
    Uploaded the calculation that were done to calculate the torque of motor required.
2024-11-14 Rename Page1.jpg to Motor power requirement calculations.jpg
2024-11-14 Create Arduino Movement control
2024-11-14 Create Arduino Tilt mechanism control
2024-11-17 Update Arduino Movement control
